cdrfiunlp/seguidorCDR2019/src/sensorestest/README.txt

Carpeta con un sketch para probar los sensores.

Se toman muestras de los valores de los sensores cada 5 ms y se envían los datos por puerto serie 
(tanto por BLUETOOTH como por la interfaz serie común).
