cdrfiunlp/seguidorCDR2019/src/seguidor/README.txt

Carpeta con el sketch que usaría el Seguidor.
