cdrfiunlp/seguidorCDR2019/hardware/LineFollowerCDR2018_MainBaord DIP/Imagenes/MainBoardPCBBOTTOM.png

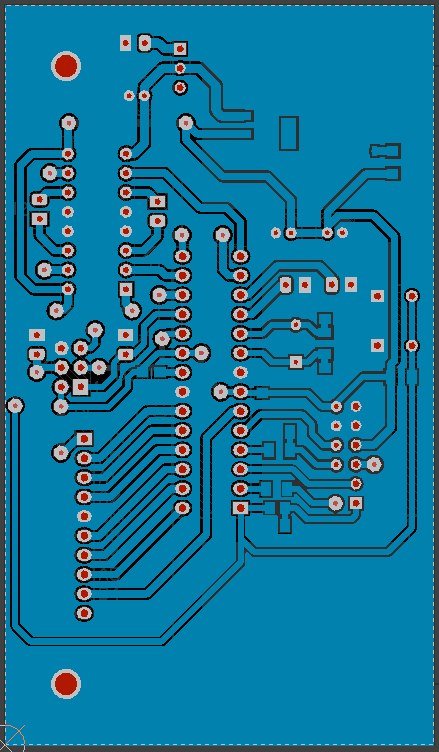
hardware/LineFollowerCDR2018_MainBaord DIP/Imagenes/MainBoardPCBBOTTOM.png
