cdrfiunlp/seguidorCDR2019/hardware/LineFollowerCDR2018_MainBaord DIP/Imagenes/MainBoardPCBTOP.png

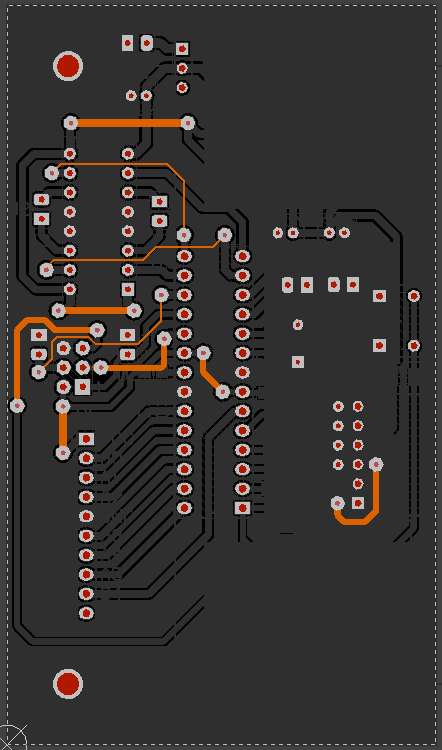
hardware/LineFollowerCDR2018_MainBaord DIP/Imagenes/MainBoardPCBTOP.png
