cdrfiunlp/seguidorCDR2019/hardware/LineFollowerCDR2018_SensorsBoard - ReverseLogic/Imagenes/SensorBoardPCBTOP.png

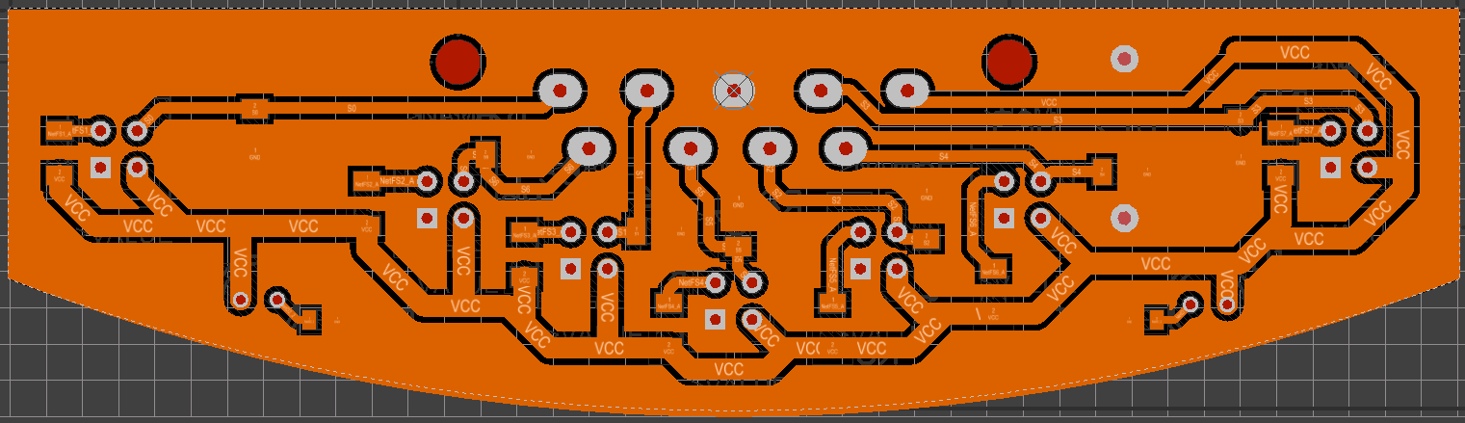
hardware/LineFollowerCDR2018_SensorsBoard - ReverseLogic/Imagenes/SensorBoardPCBTOP.png
