cdrfiunlp/seguidorCDR2019/hardware/LineFollowerCDR2018_MainBaord DIP/Esquematico.pdf

# ATMEGA328PU (DIP)

# Entrada VIN (7.4V) y switch

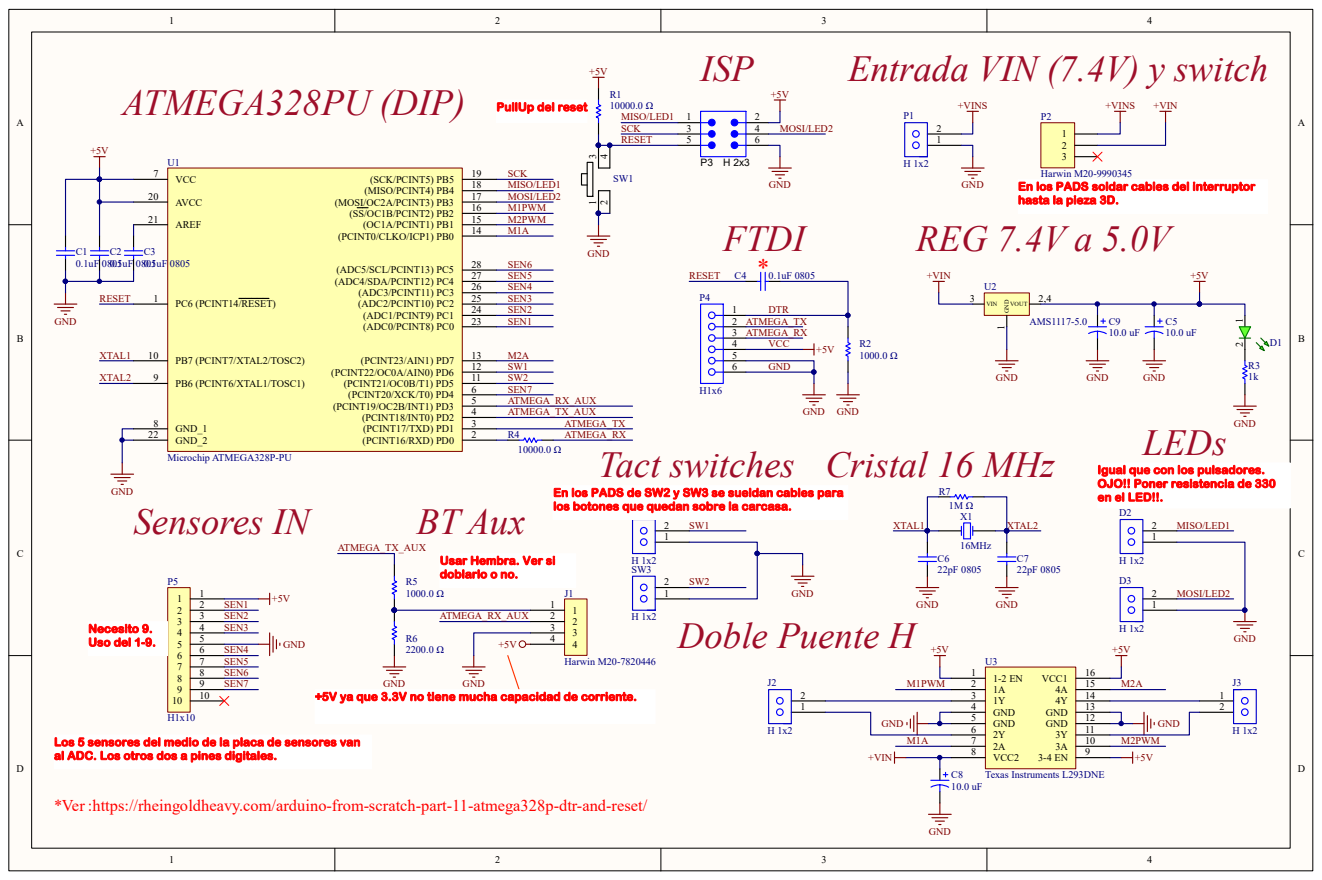
[picture p8: page 1]

Igual que con los pulsadores.
OJO!! Poner resistencia de 330
en el LED!!.

En los PADS de SW2 y SW3 se sueldan cables para
los botones que quedan sobre la carcasa.

Usar Hembra. Ver si
doblarlo o no.

+5V ya que 3.3V no tiene mucha capacidad de corriente.

Los 5 sensores del medio de la placa de sensores van
al ADC. Los otros dos a pines digitales.

*Ver :https://rheingoldheavy.com/arduino-from-scratch-part-11-atmega328p-dtr-and-reset/
