cdrfiunlp/seguidorCDR2019/hardware/LineFollowerCDR2018_SensorsBoard - ReverseLogic/Esquematico.pdf

# - Colocar 9 PADS para soldar Cables en la capa superior - VCC deben ser 5V

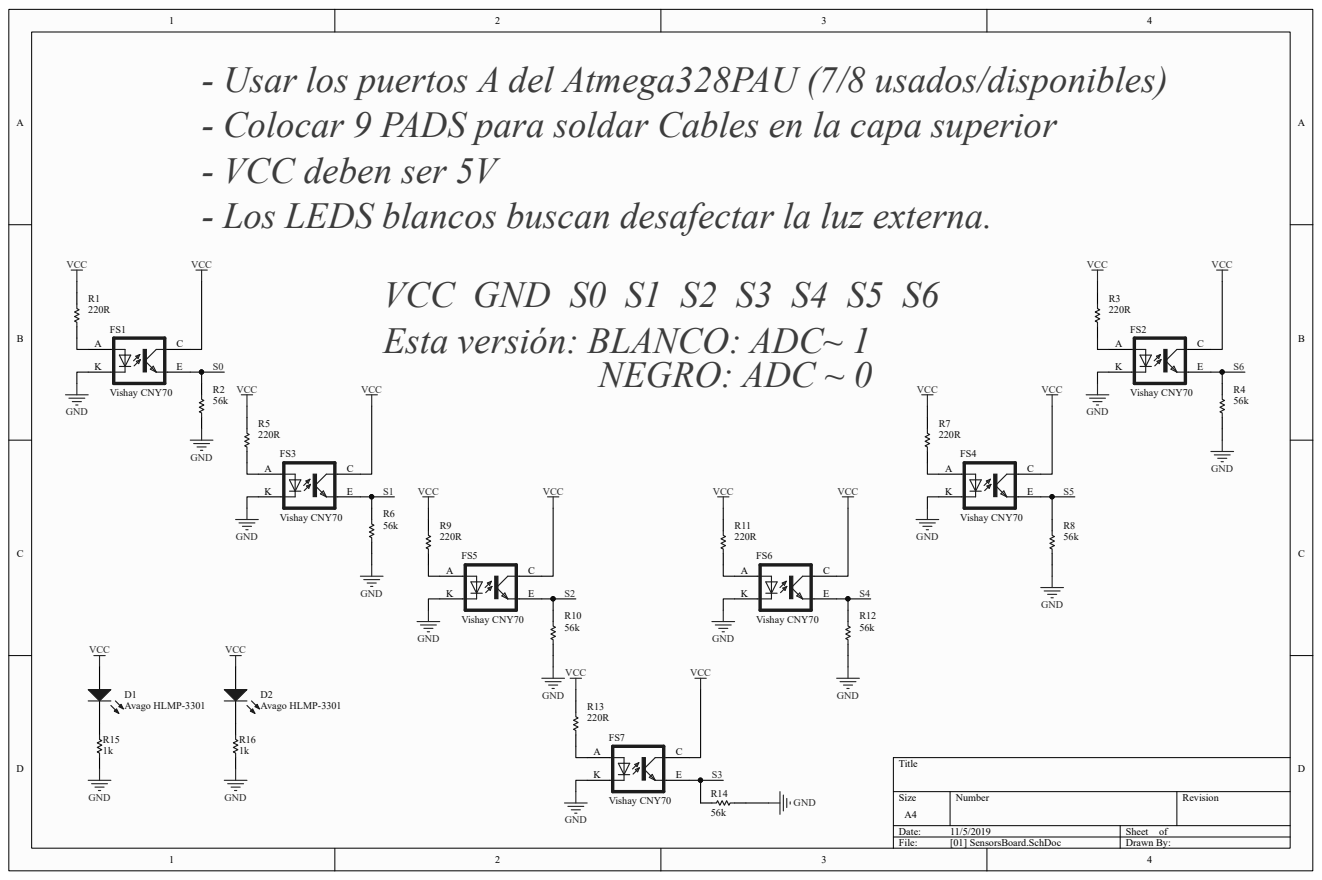
[picture p9: page 1]

- Usar los puertos A del Atmega328PAU (7/8 usados/disponibles)

- Los LEDS blancos buscan desafectar la luz externa.

VCC GND S0 S1 S2 S3 S4 S5 S6
Esta versión: BLANCO: ADC~ 1
