cdrfiunlp/seguidorCDR2019/src/seguidor/main/main.ino

#define KP 1  
#define KD 2.5	// Probar con KD >> KP 
#define VEL_MAX 150
#define VEL VEL_MAX/3*2// con 200
#define DT 1000  // Cada 1 ms accion de control.

#define M1PWM 10
#define M1A 8
#define M2PWM 9
#define M2A 7
#define LED1 12
#define LED2 11

#define S1 A0
#define S2 A2
#define S3 A3
#define S4 A4
#define S5 A5


#define DT2 50000 // 200000

#define BOTON 6

// TIME 
unsigned long dt = 0; 
unsigned long Now = 0;
unsigned long LastTime[1] = {0};
unsigned long LastTime2[1] = {0};

// CONTROLLER
float LastError[1] = {0};
float Error[1] = {0};
float Constantes[4] = {KP,KD,DT,VEL};
int Vel_filtrada[1] = {0};

// SENSORES
boolean Ledon_state = false;

// STATES
byte Flags[1] = {0};
boolean Flag = false;

void setup(){
  
  Serial.begin(9600);
  Serial.println("/*** sigue_linea_PD ***/");
  Serial.println("*** INITS ***");
  LEDsInit();
  MotoresInit(M1A, M2A);
  ApagarMotores(M1PWM, M1A, M2PWM, M2A);
  //pinMode(BOTON,INPUT_PULLUP); // Boton para programa

  /*while(digitalRead(BOTON) == 1)
  { 
	LEDsBlink(1, 1, 1, 100);
  }*/

  ApagarMotores(M1PWM, M1A, M2PWM, M2A);
  LEDsDrive(1,1);
  
  /*while(digitalRead(BOTON) == 1){}*/
  
  Serial.println("*** GO! ***");
  LEDsDrive(0,0);
  delay(3000);
  Flag = true;      // Para que inicie sin el boton
  
}

void loop(){
  
  /*if(digitalRead(BOTON) == 0)
  {
   Flag = !Flag;
   delay(200); 
  }*/
  
  if(Flag == true)
  {
    Now = micros();
    dt = Now - *LastTime;     

    if(dt > Constantes[2])
    {
      Vel_filtrada[0] = LecturaSensores2(1, 0, Error, LastError, LastTime2, Flags);
      SeguirLinea(M1PWM, M1A, M2PWM, M2A, Vel_filtrada[0], Constantes[3], 0);  // Probar varios delays
      *LastTime = Now;
    }
    
  }
  else
  {
    LEDsDrive(0,0);
    ApagarMotores(M1PWM, M1A, M2PWM, M2A);
  }
  
}
