cdrfiunlp/seguidorCDR2019/(commit log)

2019-10-30 codigo de prueba funcional del seguidor
2019-11-05 corrección link de fotos
2019-11-06 correccion links README y pines de leds y botones. Codigo prueba con boton
2019-11-06 Recorrección de links -.-
